jramachandran46-maker/Skyhook_Damping/PXL_20260817_165850455.MP.jpg

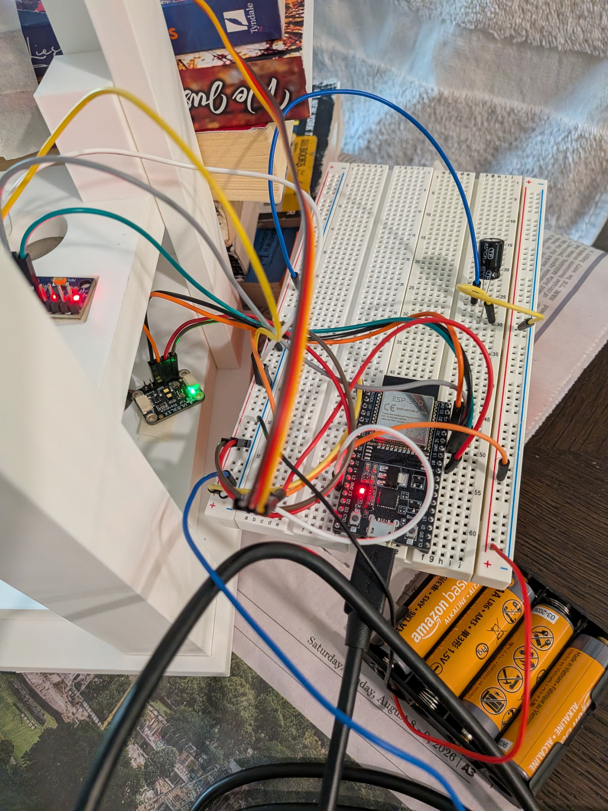
PXL_20260817_165850455.MP.jpg
