jramachandran46-maker/Skyhook_Damping/PXL_20260817_165846905.jpg

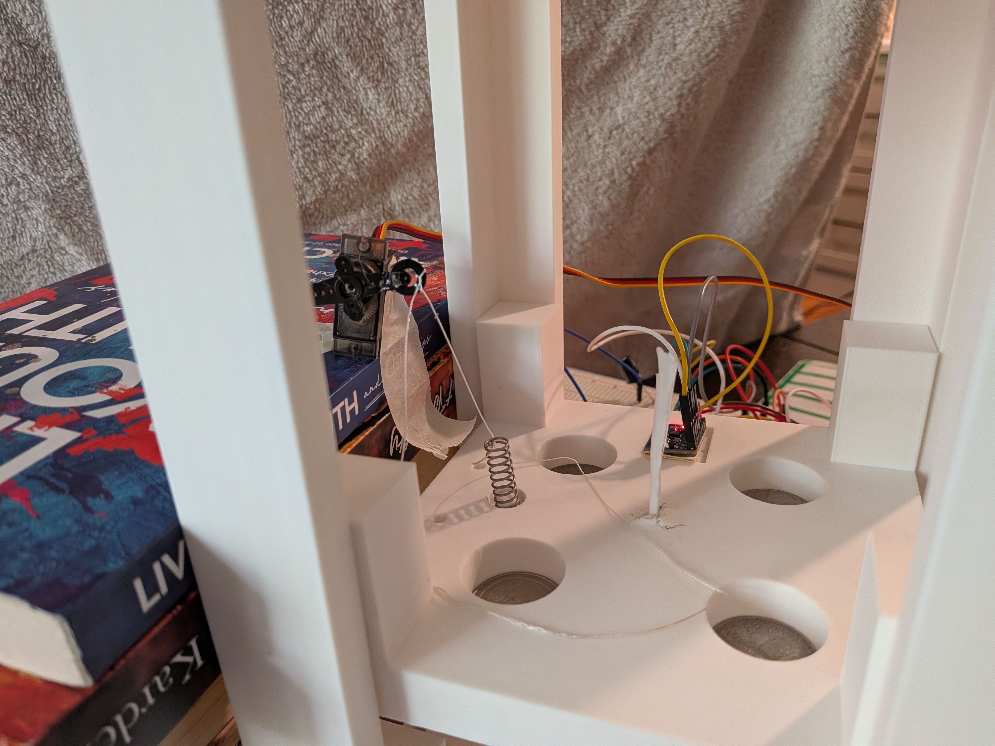
PXL_20260817_165846905.jpg
