jramachandran46-maker/Skyhook_Damping/PXL_20260817_004749622~2.jpg

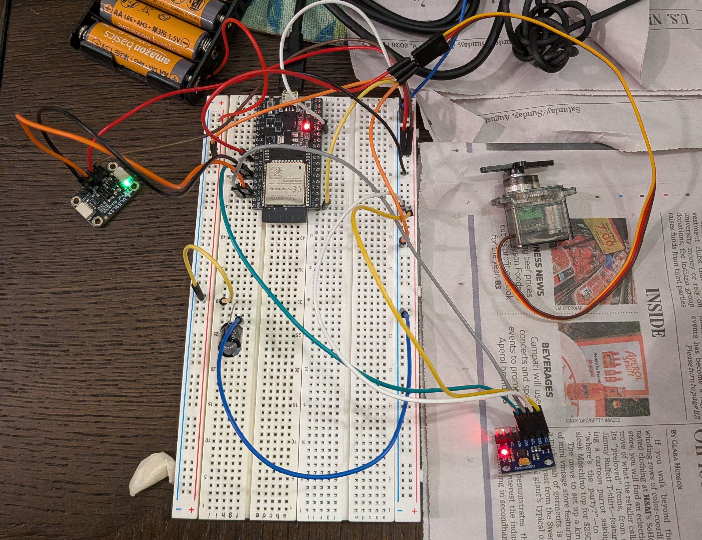
PXL_20260817_004749622~2.jpg
