jramachandran46-maker/Skyhook_Damping/rig-diagram-labeled (1).png

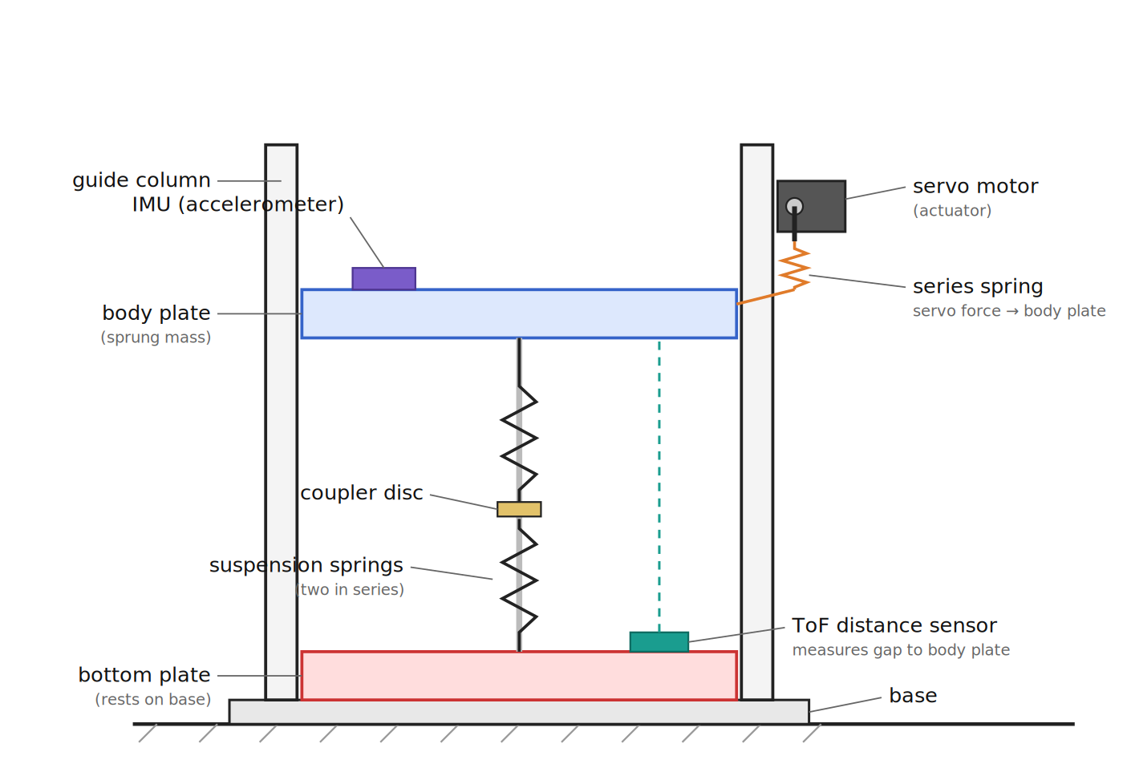
rig-diagram-labeled (1).png
